ES0R/Bachelor/drone_ctrl/doc/block-control.png

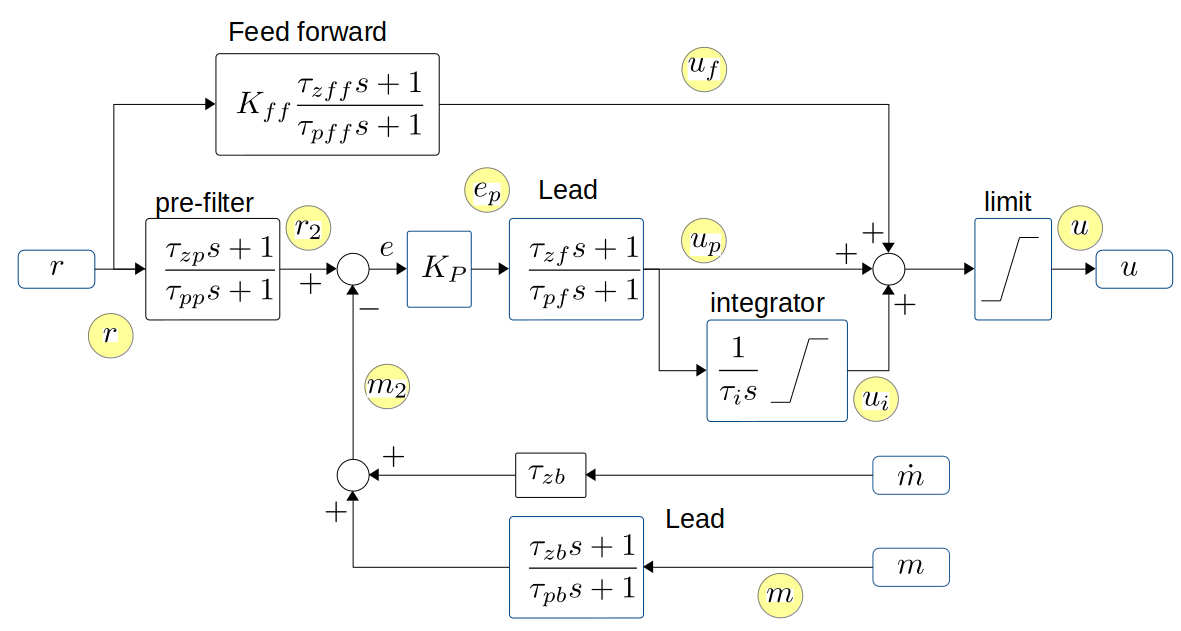
drone_ctrl/doc/block-control.png
