ES0R/Bachelor/drone_ctrl/doc/block-functions.png

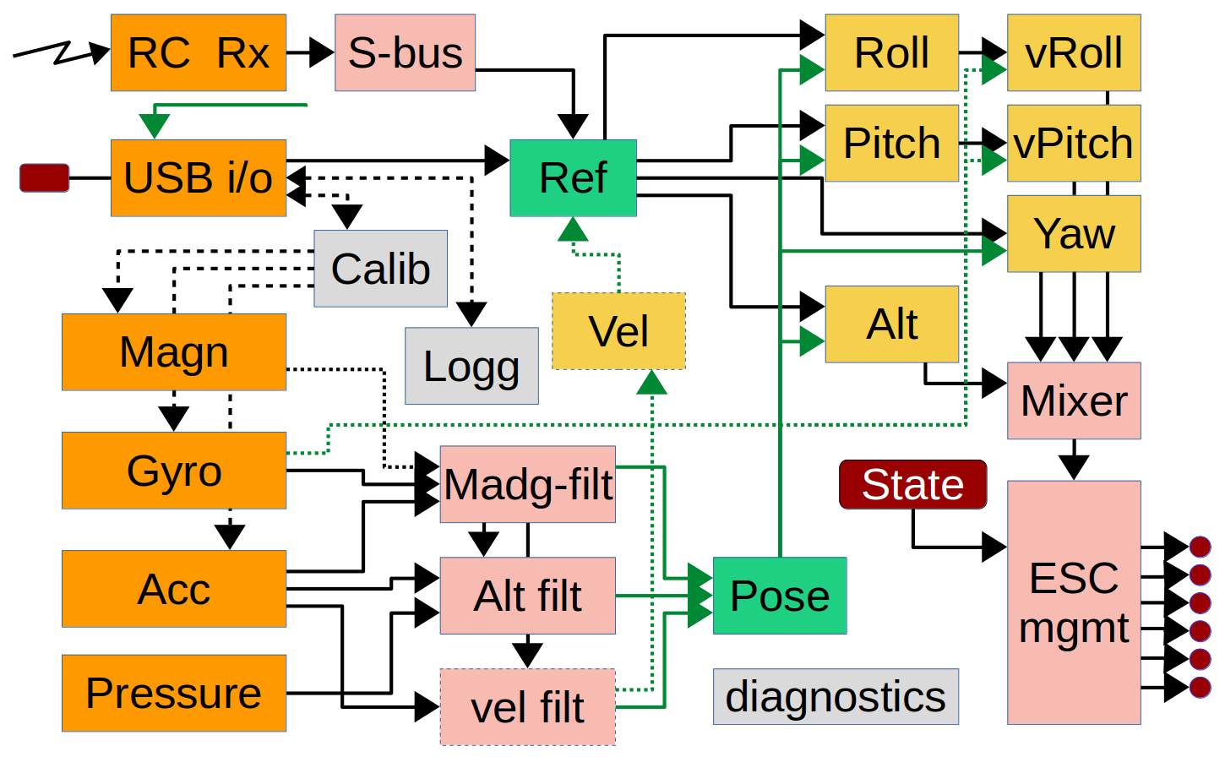
drone_ctrl/doc/block-functions.png
