ES0R/Bachelor/drone_ctrl/doc/schematic_rev1.png

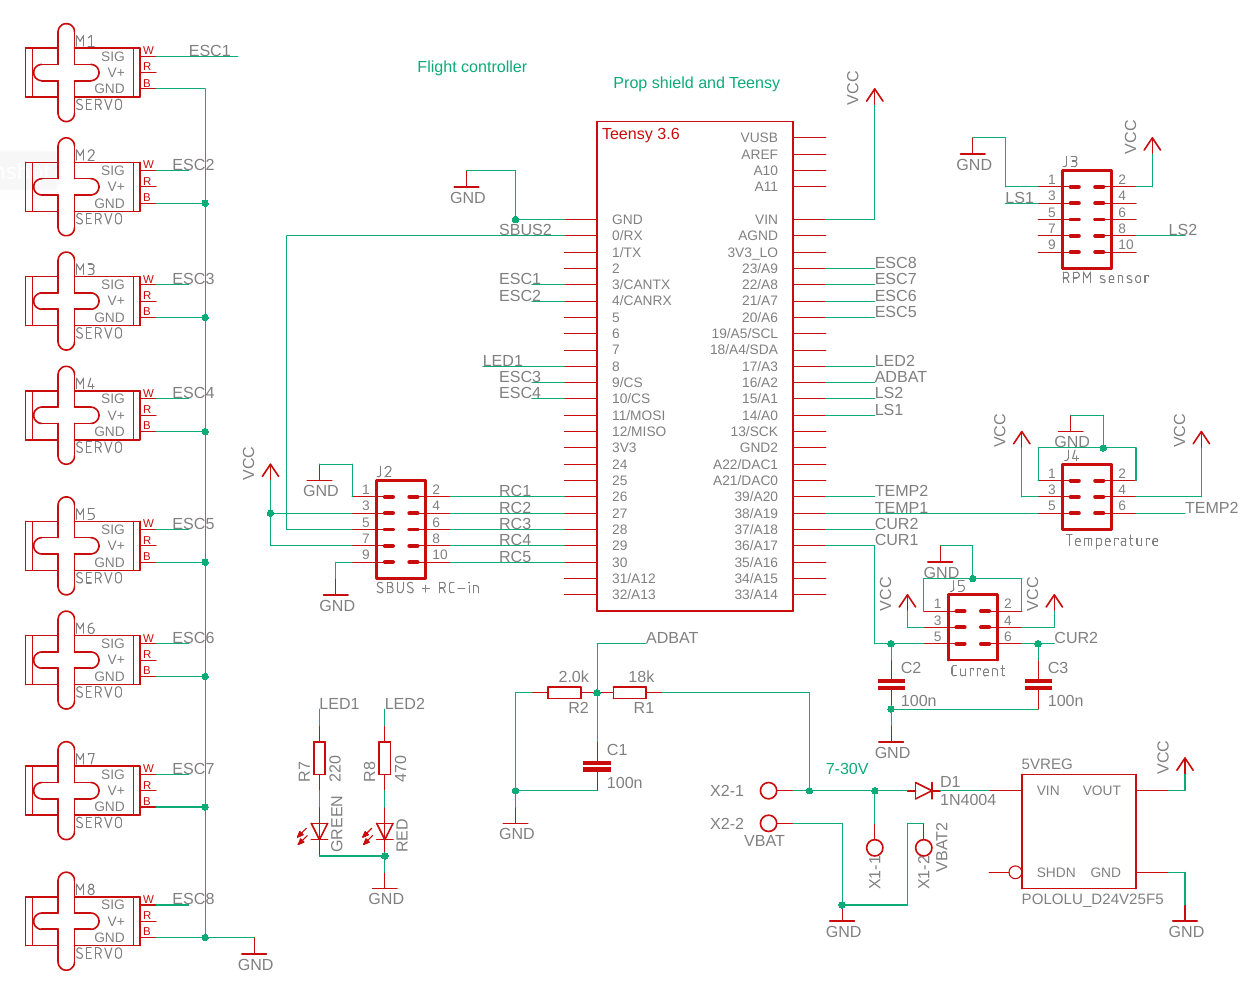
drone_ctrl/doc/schematic_rev1.png
