ES0R/Bachelor/drone_ctrl/drone_gui/log/3508-700-drag-constant.png

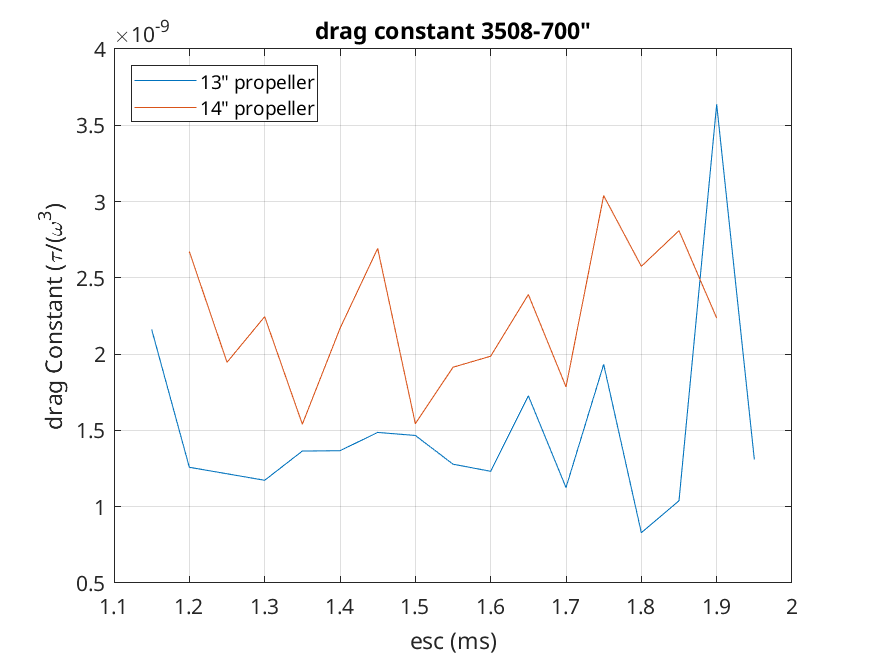
drone_ctrl/drone_gui/log/3508-700-drag-constant.png
