ES0R/Bachelor/drone_ctrl/drone_gui/log/3508-700-trust-constant.png

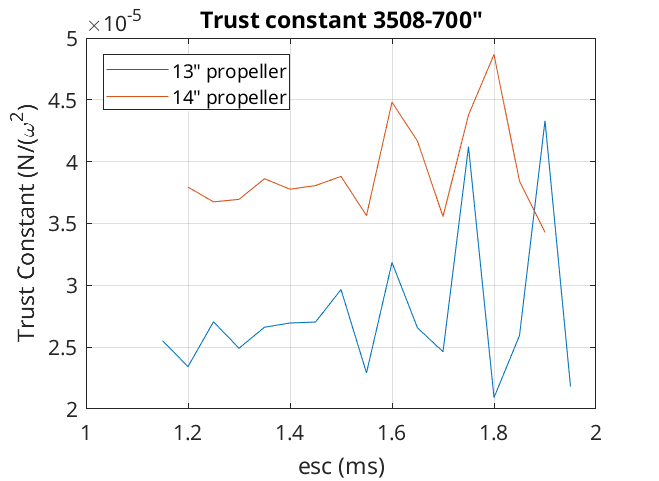
drone_ctrl/drone_gui/log/3508-700-trust-constant.png
