ES0R/Bachelor/drone_ctrl/drone_gui/log/rpm-per-power-3508-700.png

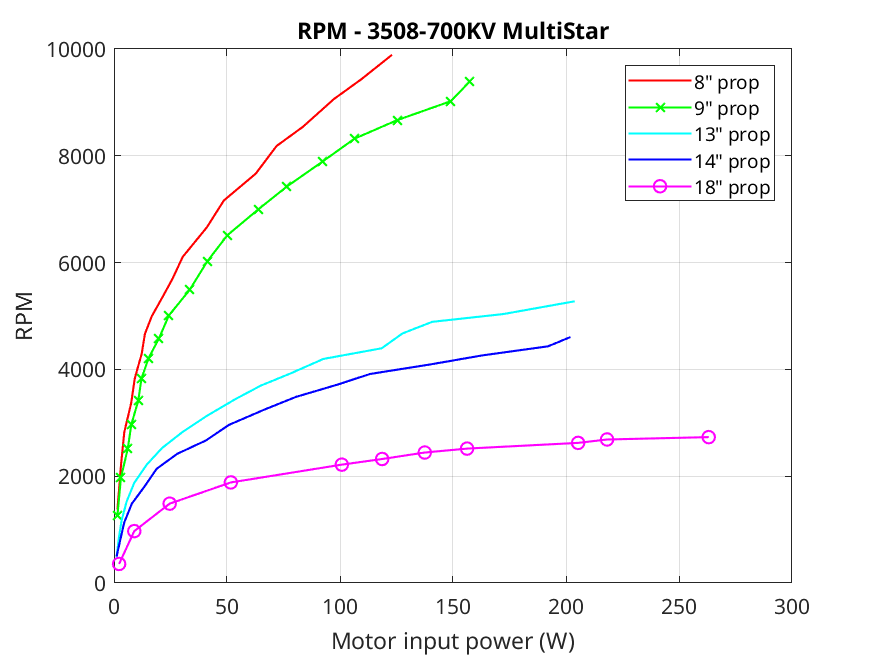
drone_ctrl/drone_gui/log/rpm-per-power-3508-700.png
