ES0R/Bachelor/drone_ctrl/drone_gui/log/transfer_gain_N-per-ms.png

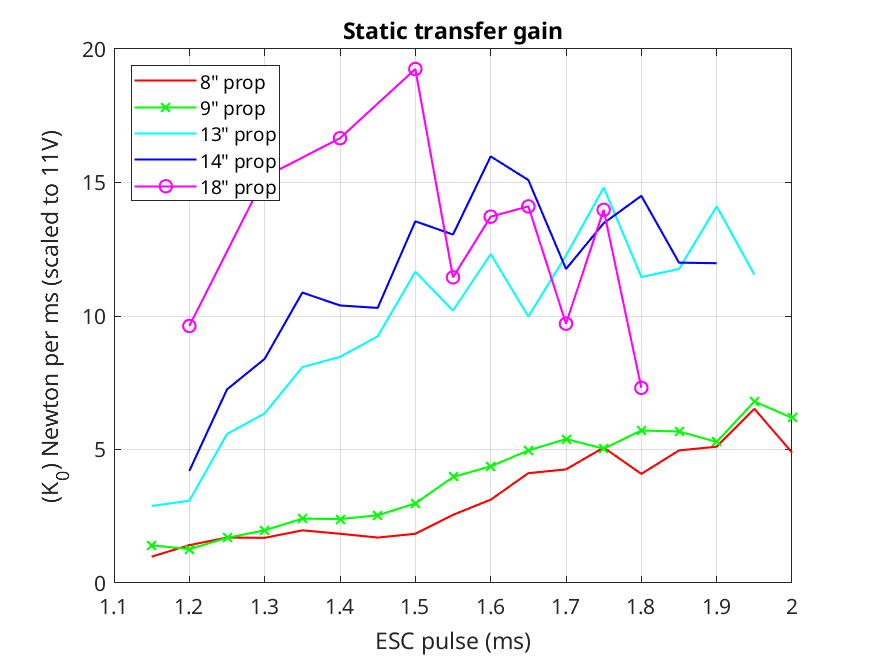
drone_ctrl/drone_gui/log/transfer_gain_N-per-ms.png
