ES0R/Bachelor/drone_ctrl/drone_gui/log/trust-3508-700_14_18x5.5.png

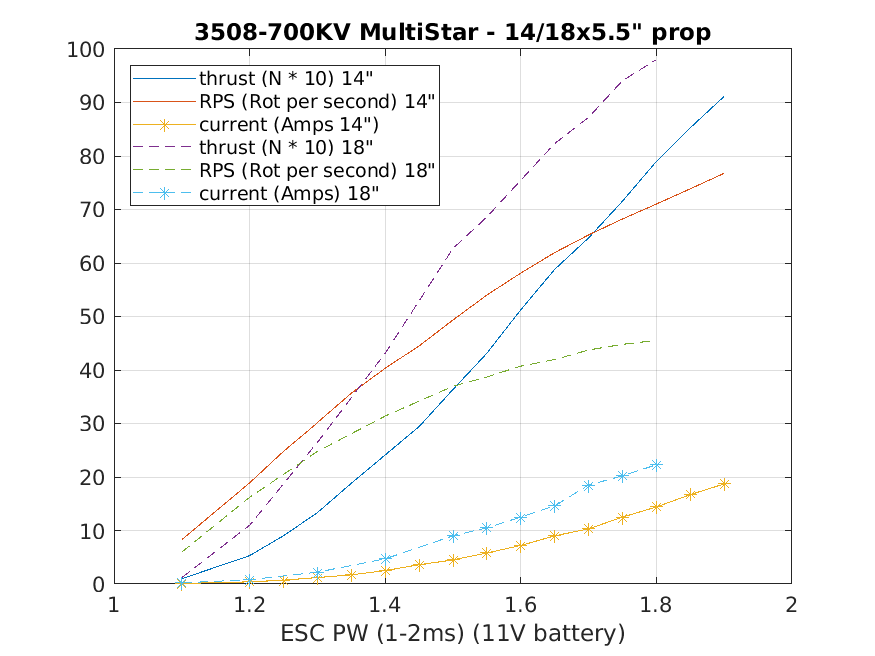
drone_ctrl/drone_gui/log/trust-3508-700_14_18x5.5.png
