ES0R/Bachelor/Drone/Matlab/battery.step

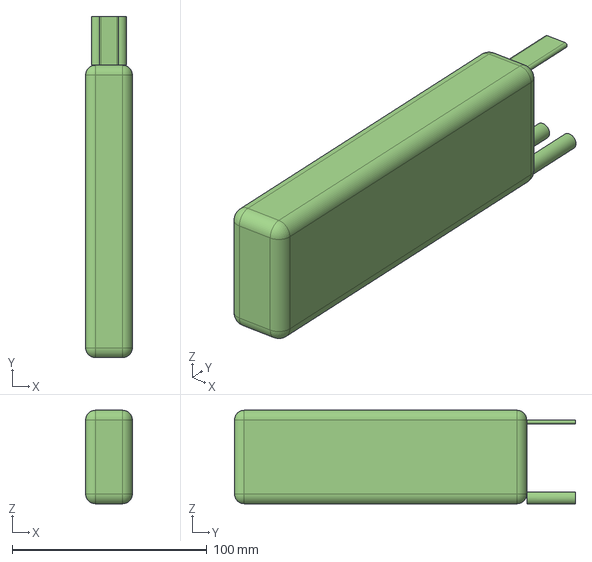
[picture p12: CAD file, 2022-02-07]
Drone/Matlab/battery.step
24.0 x 175.0 x 48.0 mm
