ES0R/Bachelor/Drone/Matlab/foot_mount.step

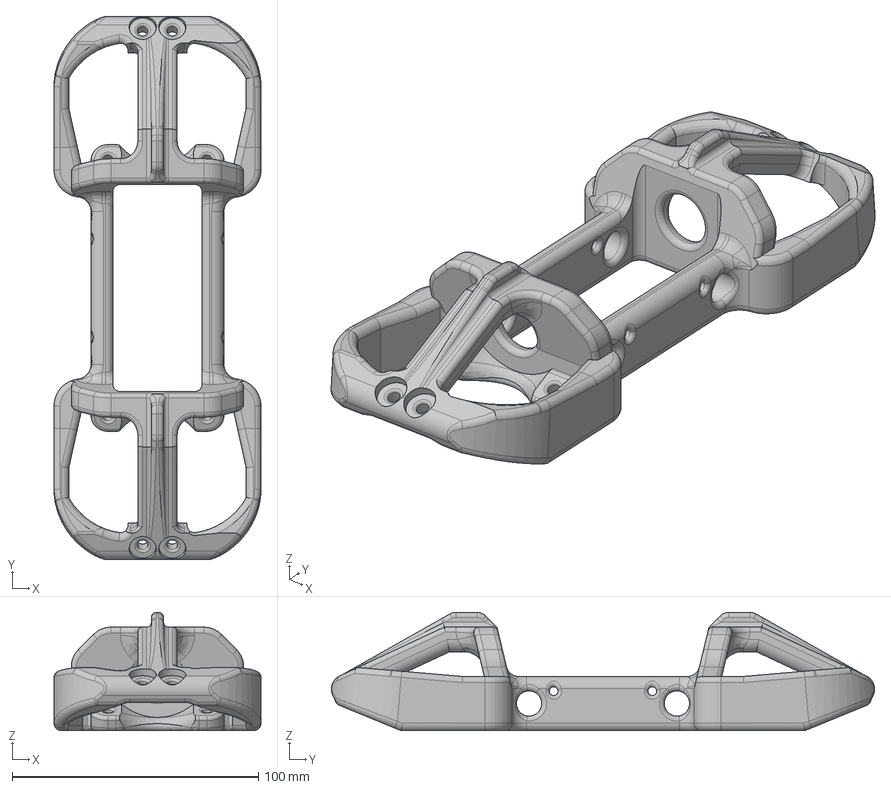
[picture p13: CAD file, 2022-02-07]
Drone/Matlab/foot_mount.step
84.0 x 220.4 x 48.0 mm
