ES0R/Bachelor/Drone/Matlab/motor-mount.step

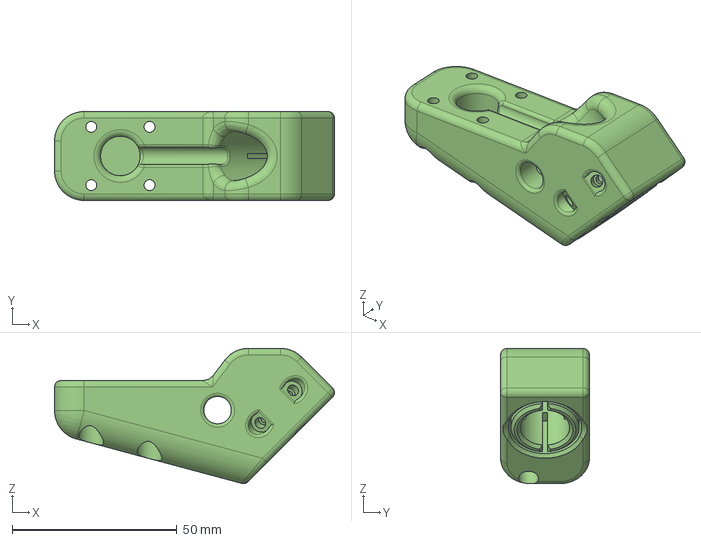
[picture p14: CAD file, 2022-02-07]
Drone/Matlab/motor-mount.step
85.0 x 27.0 x 41.0 mm
