ES0R/Bachelor/Drone/Matlab/18_inch_prop.step

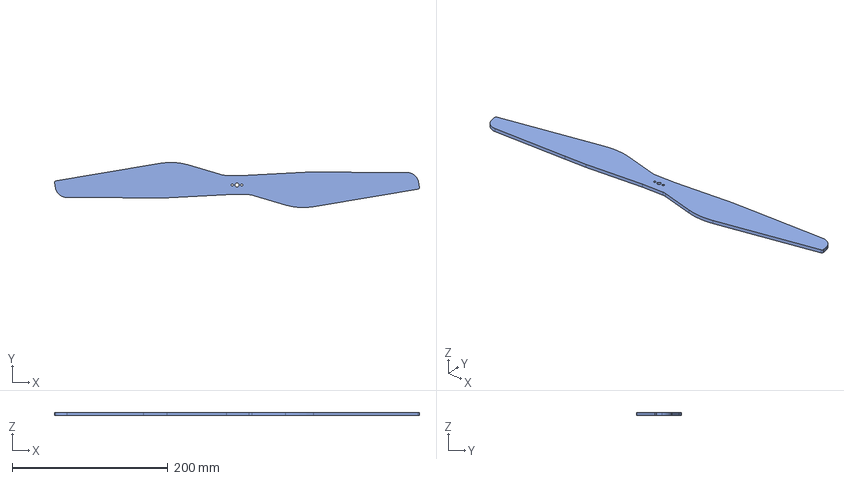
[picture p15: CAD file, 2022-02-07]
Drone/Matlab/18_inch_prop.step
469.4 x 58.0 x 4.00 mm
