ES0R/Bachelor/Drone/Matlab/leg2.step

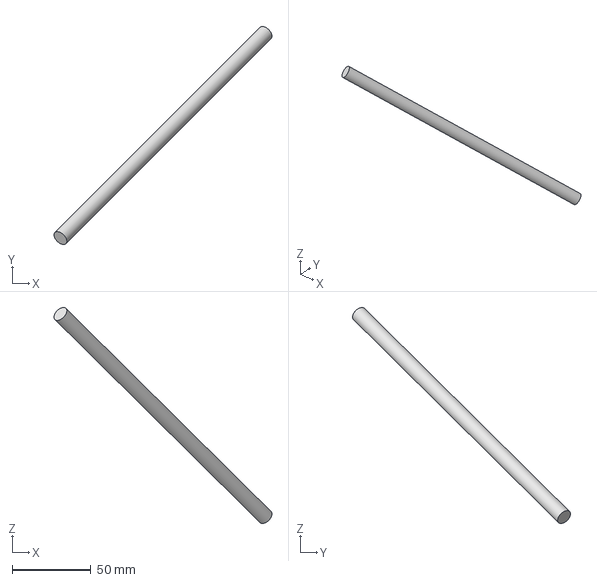
[picture p16: CAD file, 2022-02-07]
Drone/Matlab/leg2.step
138.5 x 138.5 x 137.2 mm
