ES0R/Bachelor/Drone/Matlab/Foot_ball.step

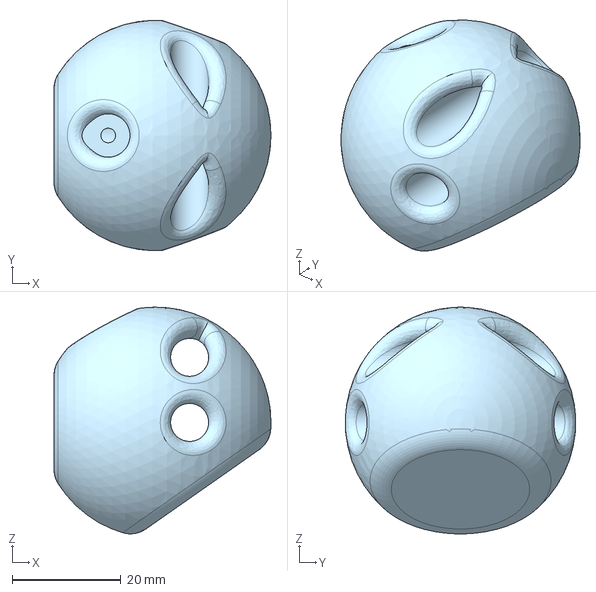
[picture p17: CAD file, 2022-02-07]
Drone/Matlab/Foot_ball.step
40.0 x 42.5 x 41.8 mm
