ES0R/Bachelor/Drone/Matlab/battery-mount_4.0.step

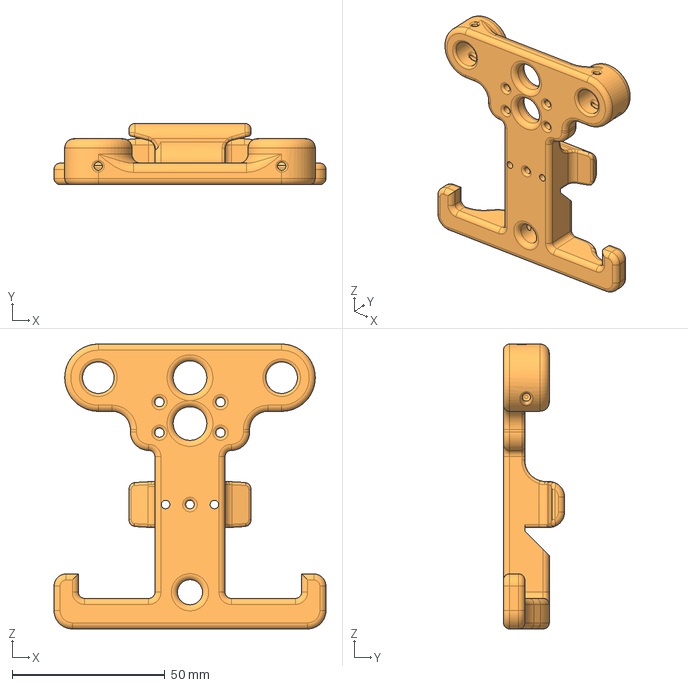
[picture p18: CAD file, 2022-02-07]
Drone/Matlab/battery-mount_4.0.step
89.0 x 20.0 x 93.2 mm
