ES0R/Bachelor/Drone/Matlab/body.step

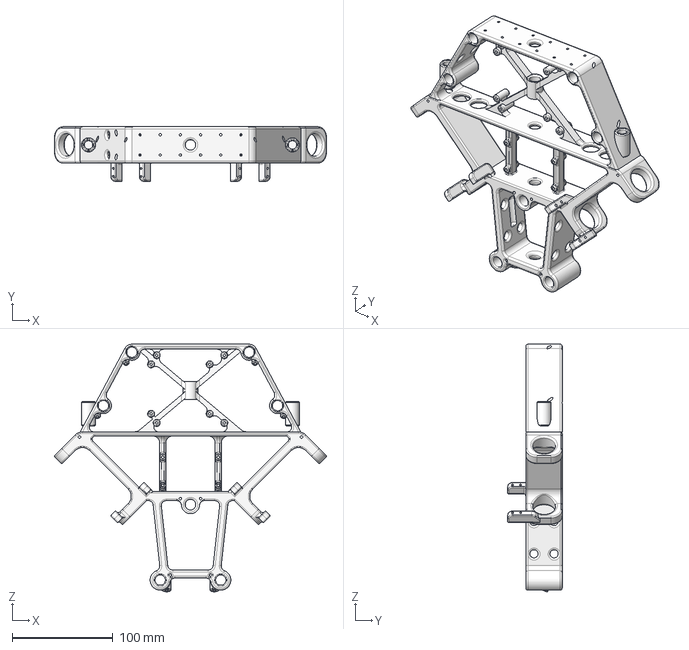
[picture p19: CAD file, 2022-02-07]
Drone/Matlab/body.step
269.5 x 54.0 x 245.4 mm
