ES0R/Bachelor/Drone/Matlab/leg-block.step

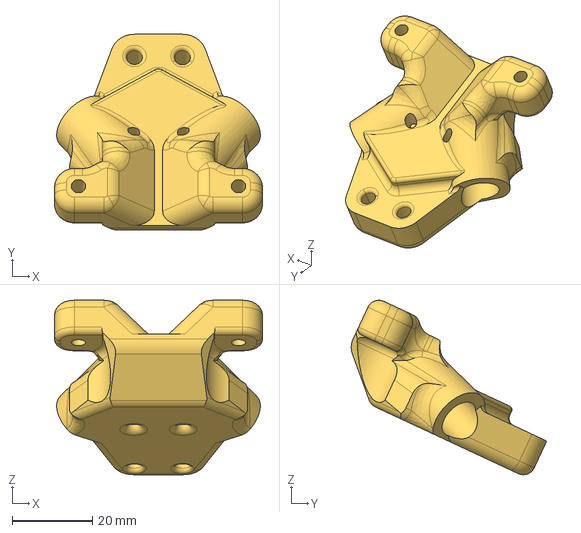
[picture p20: CAD file, 2022-02-07]
Drone/Matlab/leg-block.step
52.0 x 48.9 x 43.6 mm
