ES0R/Bachelor/drone_ctrl/drone_gui/20sYawTest9Kp.txt

% 1     Time (ms)
% 2     Arm state (init, disarmed, armed, fail)
% 3     Flight state (on ground, starting, flight, landing)
% 4     Height ref (trust ref)
% 5     Roll ref (deg)
% 6     Pitch ref (deg)
% 7     Yaw ref (deg/s)
% 8     Height value to mixer (trust ref) o/oo
% 9     Roll value to mixer o/oo
% 10    Pitch value to mixer o/oo
% 11    Yaw value to mixer o/oo
% 12    Height position (m) filtered 
% 13    Roll angle (deg)
% 14    Pitch angle (deg)
% 15    Yaw velocity (deg/s)
% 16    Height velocity (m/s)
%% 
18.44 2 0 100.00000 -0.57500 0.07500 0.15500 528.6 0.0 0.0 38.0 0.00000 -0.48015 0.85908 -4.06288 0.335 
38.41 2 0 100.00000 -0.34500 0.09000 0.46500 529.2 0.0 0.0 53.1 0.00000 -0.47085 0.93581 -5.43788 0.198 
58.42 2 0 100.00000 -0.34500 0.09000 0.00000 529.3 0.0 0.0 33.2 0.00000 -0.44765 1.07122 -3.68788 0.170 
78.44 2 0 100.00000 -0.34500 0.09000 0.00000 529.6 0.0 0.0 106.9 0.00000 -0.43171 1.02441 -11.87538 0.093 
98.25 2 0 100.00000 -0.34500 0.09000 0.00000 529.6 0.0 0.0 34.9 0.00000 -0.41148 1.27896 -3.87538 0.095 
118.43 2 0 100.00000 -0.34500 0.13500 0.00000 529.7 0.0 0.0 68.6 0.00000 -0.42207 1.39221 -7.62538 0.061 
138.40 2 0 100.00000 -0.34500 0.09000 0.00000 529.7 0.0 0.0 83.3 0.00000 -0.40525 1.41771 -9.25038 0.068 
158.42 2 0 100.00000 -0.34500 0.09000 0.00000 530.2 0.0 0.0 105.8 0.00000 -0.42379 1.62407 -11.75038 -0.054 
178.44 2 0 100.00000 -0.34500 0.09000 0.00000 530.4 0.0 0.0 -12.4 0.00000 -0.33438 1.50330 1.37462 -0.096 
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
778.40 2 0 100.00000 -0.34500 0.09000 0.00000 529.7 0.0 0.0 16.9 0.00000 -0.09906 1.50054 -1.87538 0.080 
798.44 2 0 100.00000 -0.34500 0.09000 0.00000 529.4 0.0 0.0 106.3 0.00000 -0.07761 1.44383 -11.81288 0.132 
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
