ES0R/Bachelor/drone_ctrl/doc/PCB/servo_distribute.pdf

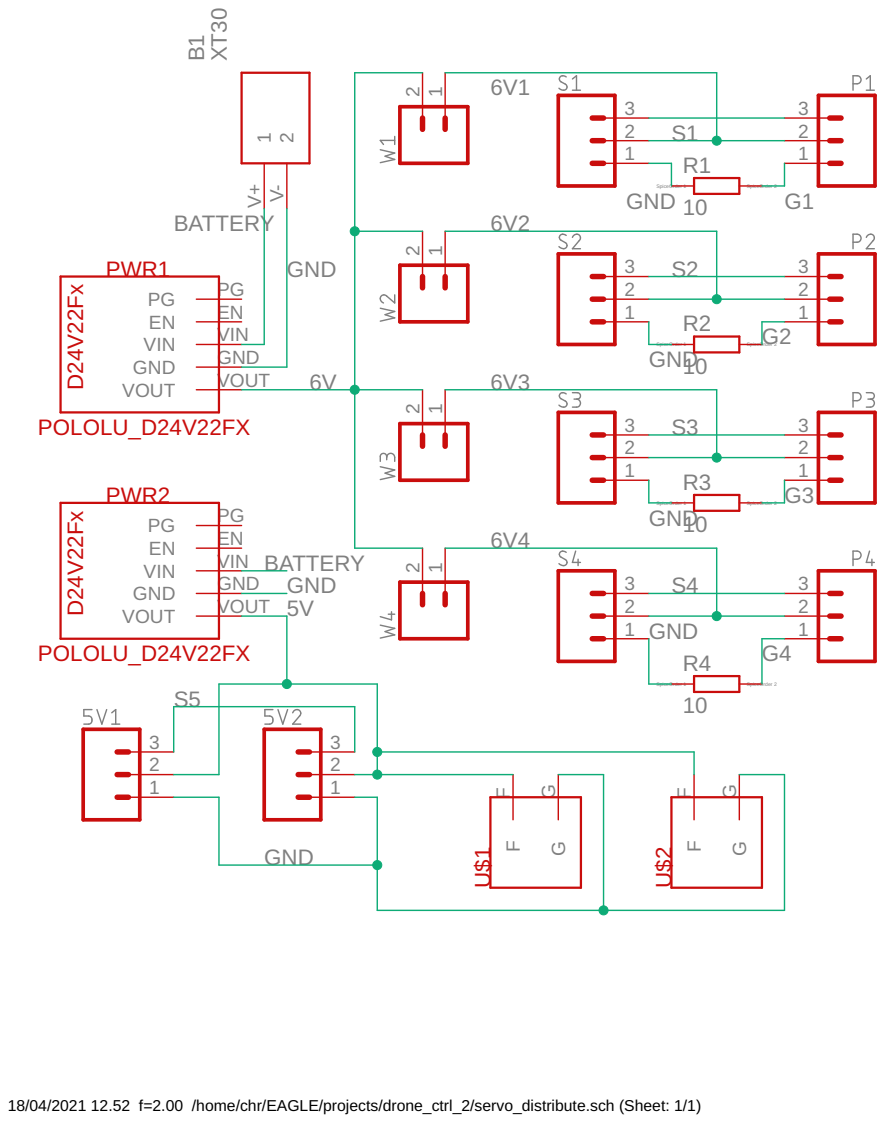
[picture p21: page 1]

18/04/2021 12.52 f=2.00 /home/chr/EAGLE/projects/drone_ctrl_2/servo_distribute.sch (Sheet: 1/1)
