ES0R/Bachelor/drone_ctrl/doc/PCB/drone_ctrl_2.pdf

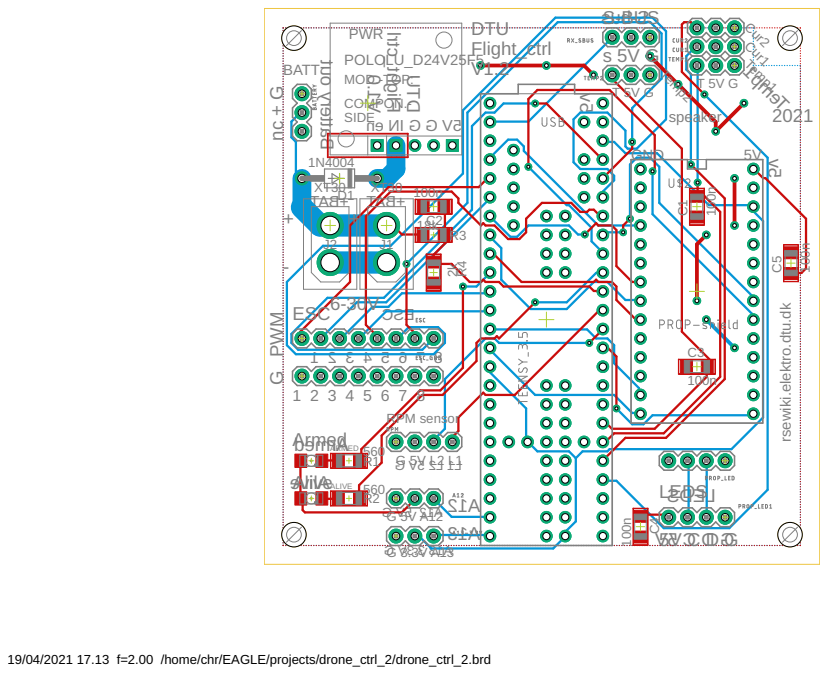
[picture p22: page 1]

19/04/2021 17.13 f=2.00 /home/chr/EAGLE/projects/drone_ctrl_2/drone_ctrl_2.brd
