ES0R/Bachelor/drone_ctrl copy/doc/PCB/power_distribute.brd

## EAGLE design drone_ctrl copy/doc/PCB/power_distribute.brd (2022-02-16, an earlier design)

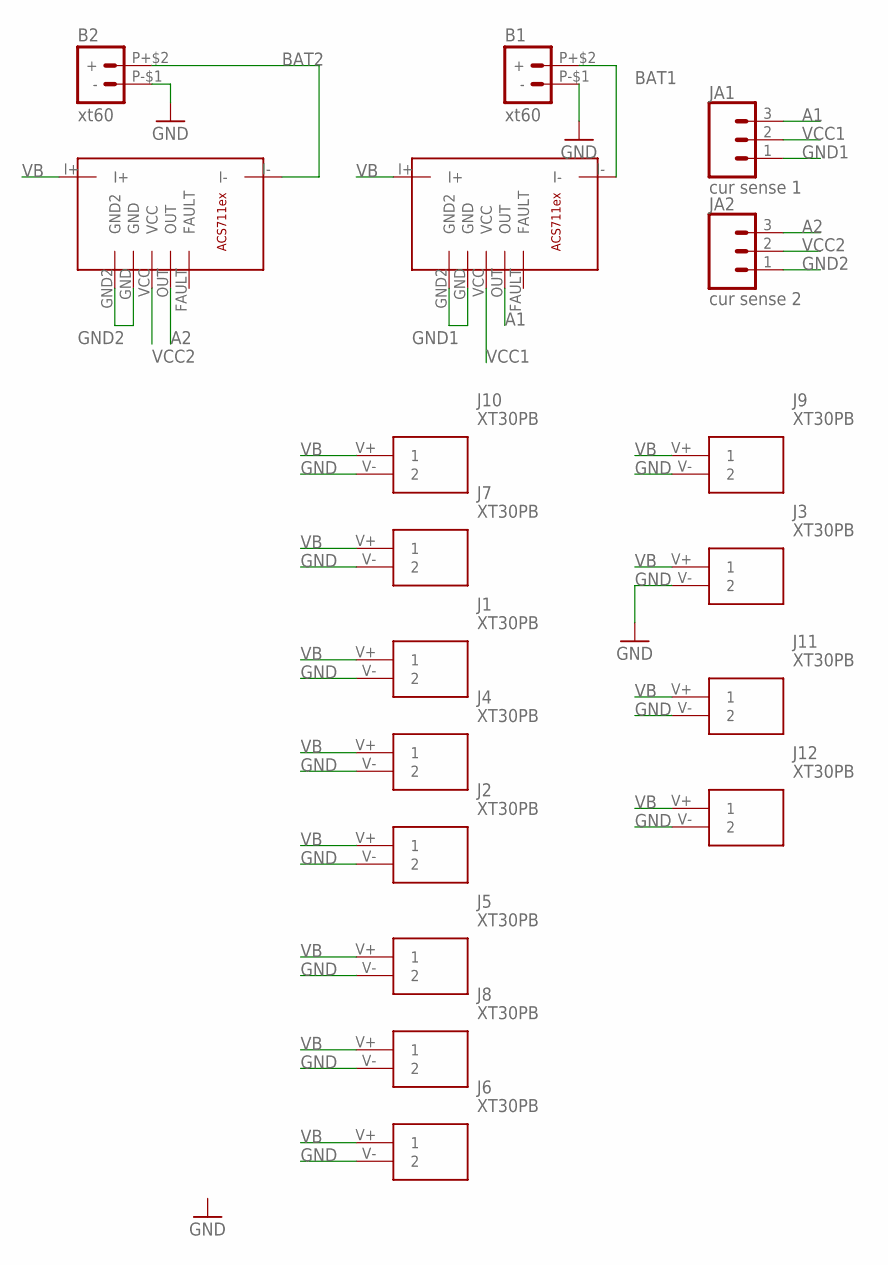
[picture p23: schematic power_distribute.sch]

Parts:
A1, A2: POLOLU_ASC711; POLOLU_ACS711
B1, B2: xt60; XT60
J1, J2, J3, J4, J5, J6, J7, J8, J9, J10, J11, J12: XT30PB
JA1: cur sense 1; 1X03
JA2: cur sense 2; 1X03

Connections:
A1: A1.OUT, JA1.3
A2: A2.OUT, JA2.3
BAT1: A1.I-, B1.P+$2 (+)
BAT2: A2.I-, B2.P+$2 (+)
GND: B1.P-$1 (-), B2.P-$1 (-), J1.V- (2), J2.V- (2), J3.V- (2), J4.V- (2), J5.V- (2), J6.V- (2), J7.V- (2), J8.V- (2), J9.V- (2), J10.V- (2), J11.V- (2), J12.V- (2)
GND1: A1.GND, A1.GND2, JA1.1
GND2: A2.GND, A2.GND2, JA2.1
VB: A1.I+, A2.I+, J1.V+ (1), J2.V+ (1), J3.V+ (1), J4.V+ (1), J5.V+ (1), J6.V+ (1), J7.V+ (1), J8.V+ (1), J9.V+ (1), J10.V+ (1), J11.V+ (1), J12.V+ (1)
VCC1: A1.VCC, JA1.2
VCC2: A2.VCC, JA2.2

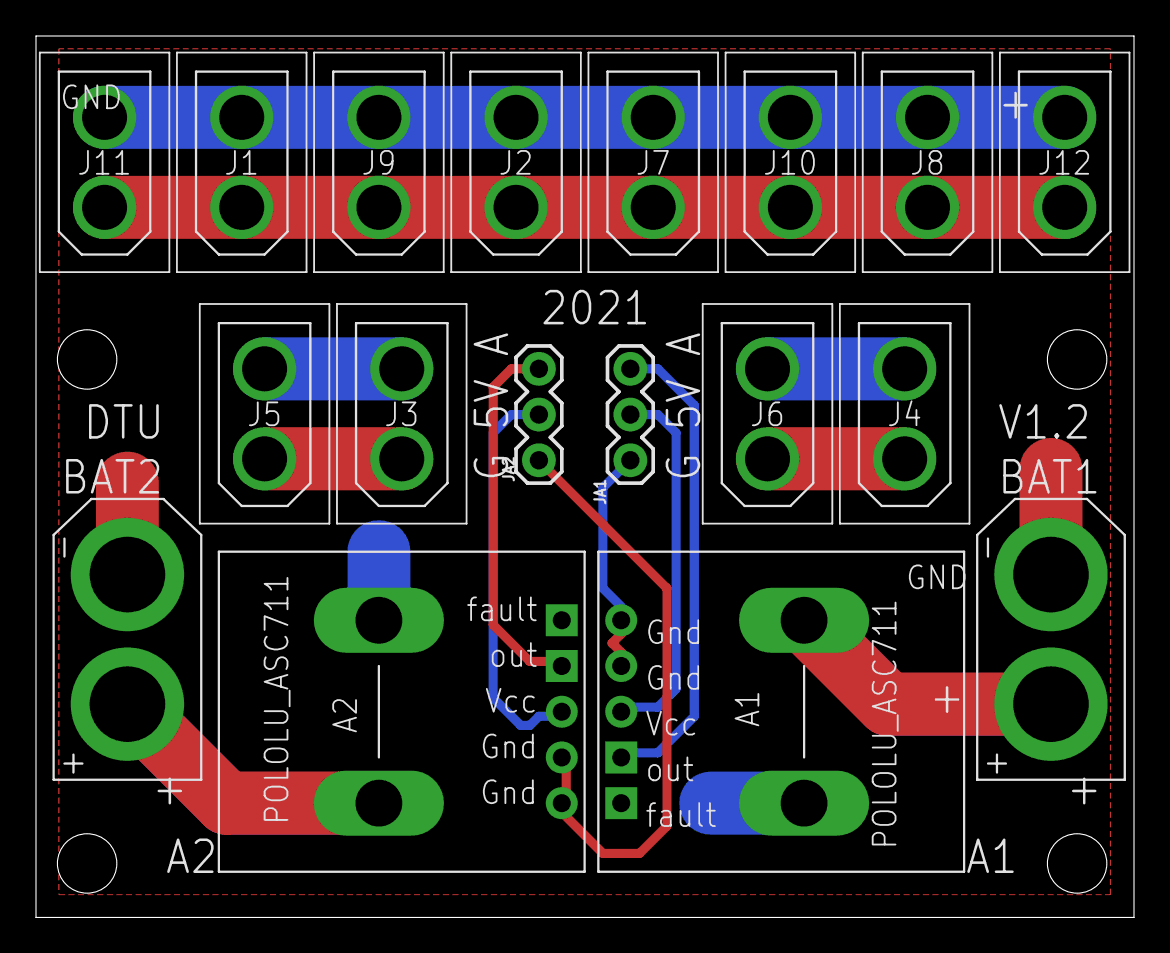
[picture p24: board power_distribute.brd from above]

Board: 2 copper layers, 61.0 x 49.0 mm, 18 parts (0 on the bottom side), 10 nets.
