ES0R/Bachelor/drone_ctrl copy/doc/PCB/servo_distribute.brd

## EAGLE design drone_ctrl copy/doc/PCB/servo_distribute.brd (2022-02-16, an earlier design)

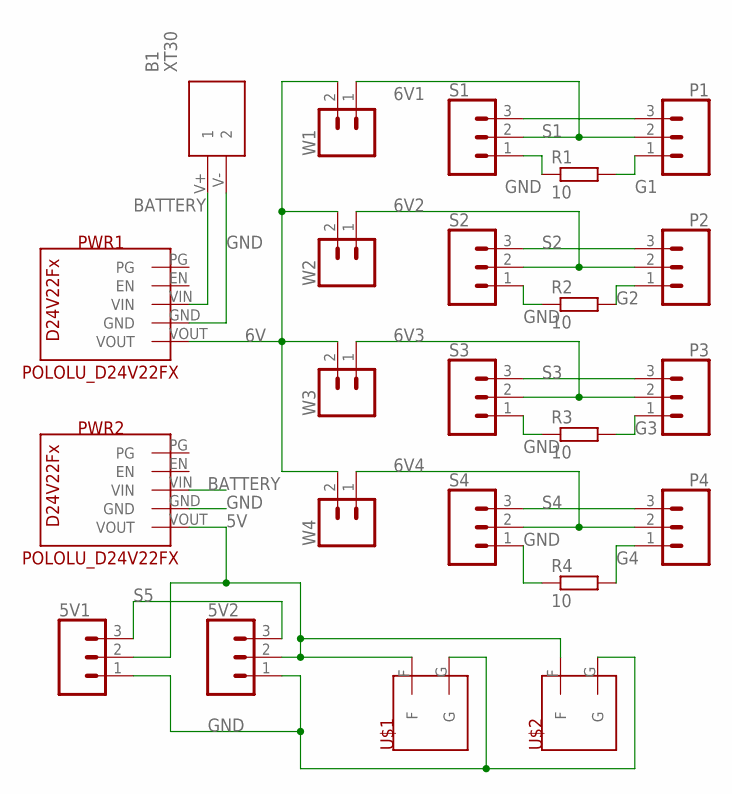
[picture p25: schematic servo_distribute.sch]

Parts:
5V1, 5V2: CONN_03; 1X03
B1: XT30; XT30PB
P1, P2, P3, P4: CONN_03; 1X03
PWR1, PWR2: POLOLU_D24V22FX; POLOLU_D24V22F6
R1, R2, R3, R4: 10; R1206
S1, S2, S3, S4: CONN_03; 1X03
U$1, U$2: TERMINAL_3.5MM
W1, W2, W3, W4: CONN_02; 1X02

Connections:
5V: 5V1.2, 5V2.2, PWR2.VOUT, U$1.F, U$2.F
6V: PWR1.VOUT, W1.2, W2.2, W3.2, W4.2
6V1: P1.2, S1.2, W1.1
6V2: P2.2, S2.2, W2.1
6V3: P3.2, S3.2, W3.1
6V4: P4.2, S4.2, W4.1
BATTERY: B1.V+ (1), PWR1.VIN, PWR2.VIN
G1: P1.1, R1.2
G2: P2.1, R2.2
G3: P3.1, R3.2
G4: P4.1, R4.2
GND: 5V1.1, 5V2.1, B1.V- (2), PWR1.GND, PWR2.GND, R1.1, R2.1, R3.1, R4.1, S1.1, S2.1, S3.1, S4.1, U$1.G, U$2.G
S1: P1.3, S1.3
S2: P2.3, S2.3
S3: P3.3, S3.3
S4: P4.3, S4.3
S5: 5V1.3, 5V2.3

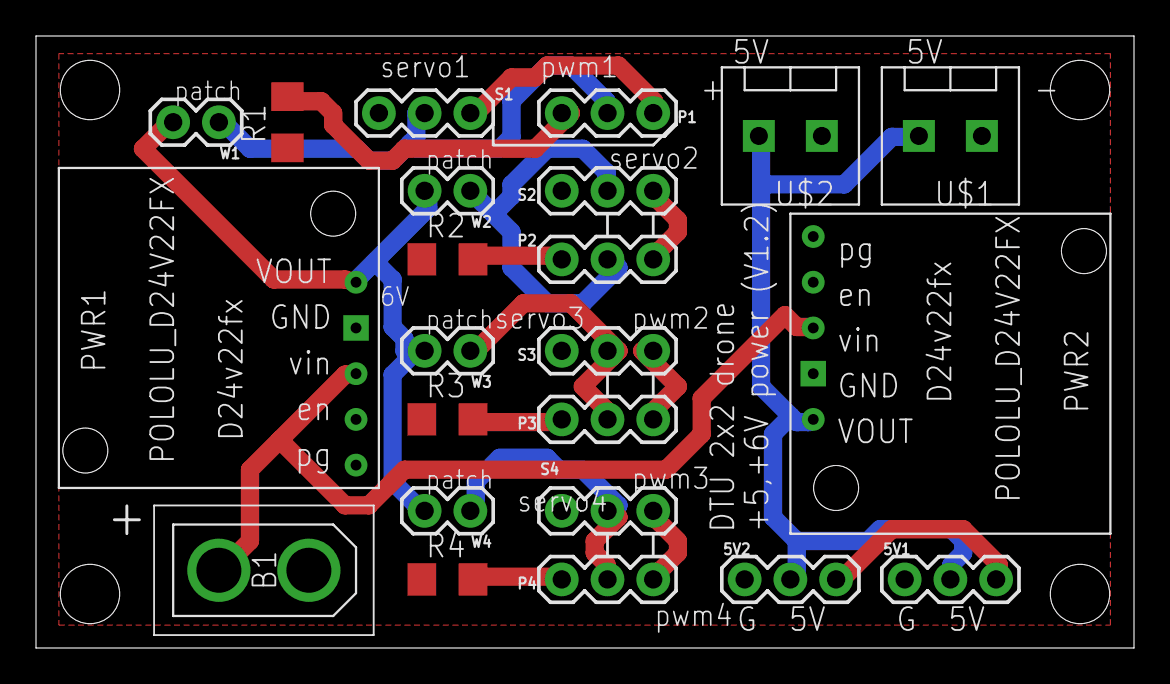
[picture p26: board servo_distribute.brd from above]

Board: 2 copper layers, 61.0 x 34.0 mm, 23 parts (0 on the bottom side), 17 nets.
