ES0R/Bachelor/drone_ctrl copy/doc/PCB/drone_ctrl_2.brd

## EAGLE design drone_ctrl copy/doc/PCB/drone_ctrl_2.brd (2022-02-16, an earlier design)

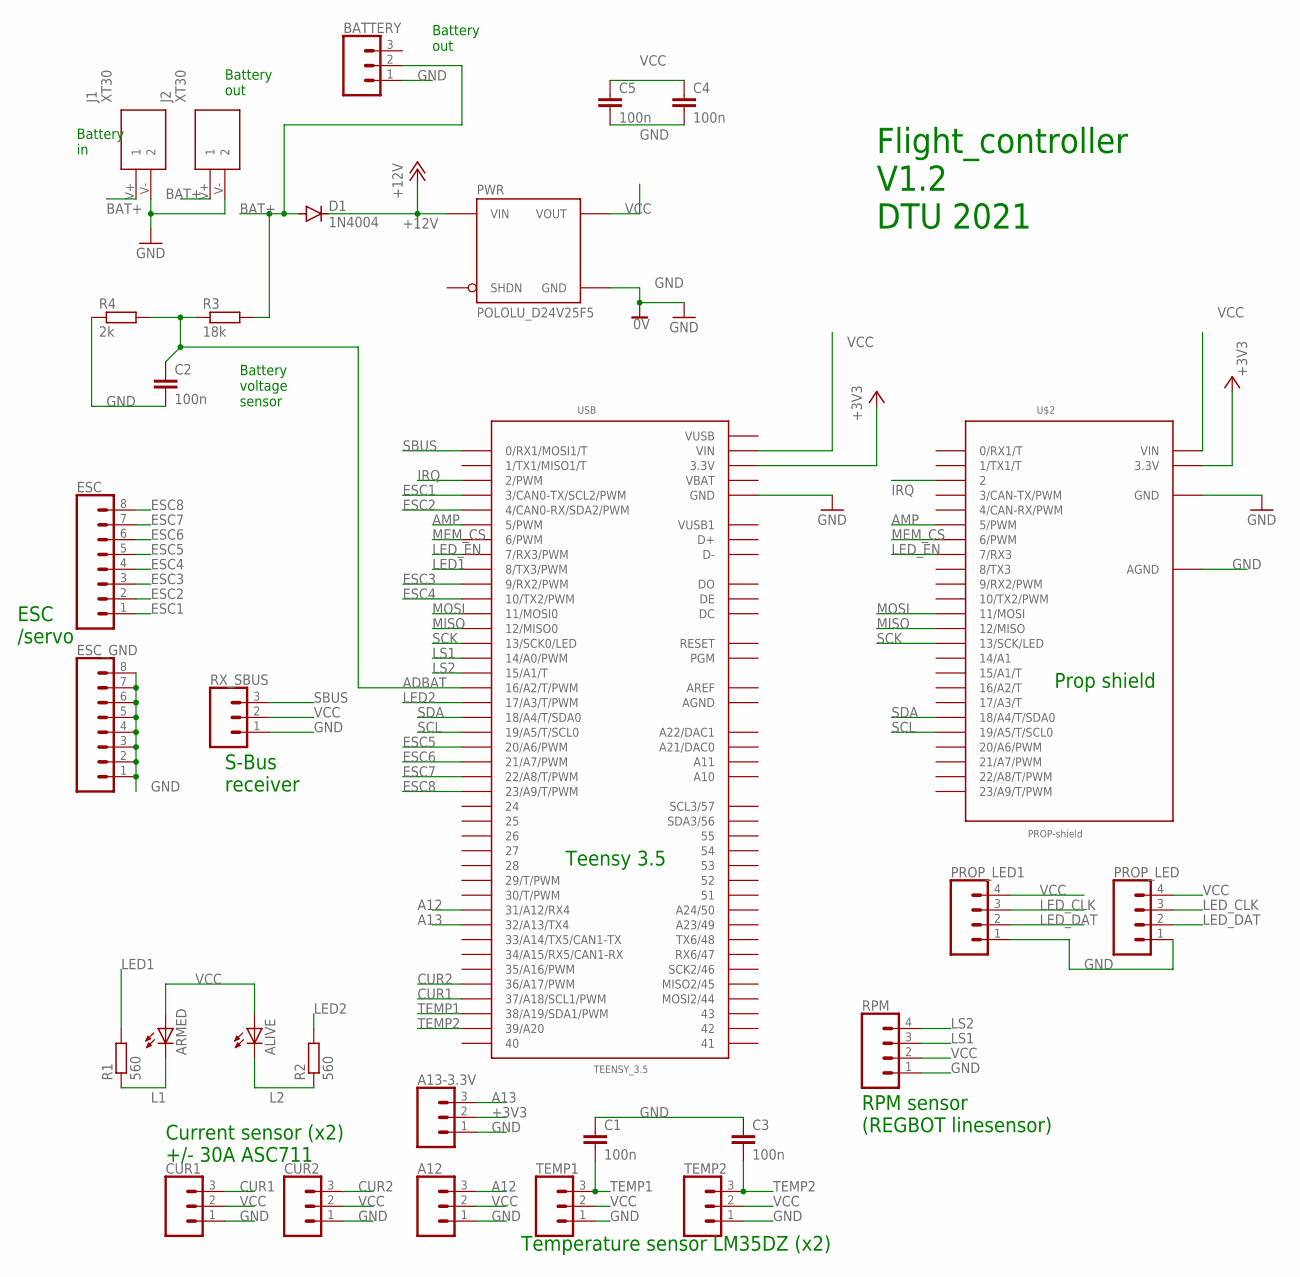
[picture p27: schematic drone_ctrl_2.sch]

Parts:
A12, A13-3.3V: CONN_03; 1X03
ALIVE: LED_E; LED_1206
ARMED: LED_E; LED_1206
BATTERY: CONN_03; 1X03
C1, C2, C3, C4, C5: 100n; C1206
CUR1, CUR2: CONN_03; 1X03
D1: 1N4004; DO41-10
ESC: CONN_08"; 1X08
ESC_GND: CONN_08"; 1X08
J1, J2: XT30; XT30PB
PROP_LED, PROP_LED1: CONN_04; 1X04
PWR: POLOLU_D24V25F5
R1, R2: 560; R1206
R3: 18k; R1206
R4: 2k; R1206
RPM: CONN_04; 1X04
RX_SBUS: CONN_03; 1X03
TEMP1, TEMP2: CONN_03; 1X03
U$2: PROP-shield; TEENSY_3.0-3.2&LC_DIL
USB: TEENSY_3.5; TEENSY_3.6_ALL_PINS&PADS

Connections:
+3V3: A13-3.3V.2, U$2.3.3V, USB.3.3V, USB.3.3V2 (3.3V), USB.3.3V3 (3.3V), USB.3.3V4 (3.3V)
+12V: D1.C, PWR.I (VIN)
A12: A12.3, USB.31/A12 (31/A12/RX4)
A13: A13-3.3V.3, USB.32/A13 (32/A13/TX4)
ADBAT: C2.1, R3.1, R4.2, USB.16/A2 (16/A2/T/PWM)
AGND: USB.AGND
AMP: U$2.5 (5/PWM), USB.5 (5/PWM)
AREF: USB.AREF
BAT+: BATTERY.2, D1.A, J1.V+ (1), J2.V+ (1), R3.2
CUR1: CUR1.3, USB.37/A18 (37/A18/SCL1/PWM)
CUR2: CUR2.3, USB.36/A17 (36/A17/PWM)
ESC1: ESC.1, USB.3 (3/CAN0-TX/SCL2/PWM)
ESC2: ESC.2, USB.4 (4/CAN0-RX/SDA2/PWM)
ESC3: ESC.3, USB.9 (9/RX2/PWM)
ESC4: ESC.4, USB.10 (10/TX2/PWM)
ESC5: ESC.5, USB.20/A6 (20/A6/PWM)
ESC6: ESC.6, USB.21/A7 (21/A7/PWM)
ESC7: ESC.7, USB.22/A8 (22/A8/T/PWM)
ESC8: ESC.8, USB.23/A9 (23/A9/T/PWM)
GND: A12.1, A13-3.3V.1, BATTERY.1, C1.1, C2.2, C3.1, C4.2, C5.2, CUR1.1, CUR2.1, ESC_GND.1, ESC_GND.2, ESC_GND.3, ESC_GND.4, ESC_GND.5, ESC_GND.6, ESC_GND.7, ESC_GND.8, J1.V- (2), J2.V- (2), PROP_LED.1, PROP_LED1.1, PWR.G (GND), PWR.G1 (GND), R4.1, RPM.1, RX_SBUS.1, TEMP1.1, TEMP2.1, U$2.AGND, U$2.GND, USB.GND, USB.GND1 (GND), USB.GND2 (GND), USB.GND3 (GND), USB.GND4 (GND), USB.GND5 (GND), USB.GND6 (GND)
IRQ: U$2.2, USB.2 (2/PWM)
L1: ARMED.C, R1.1
L2: ALIVE.C, R2.1
LED1: R1.2, USB.8 (8/TX3/PWM)
LED2: R2.2, USB.17/A3 (17/A3/T/PWM)
LED_CLK: PROP_LED.3, PROP_LED1.3
LED_DAT: PROP_LED.2, PROP_LED1.2
LED_EN: U$2.7 (7/RX3), USB.7 (7/RX3/PWM)
LS1: RPM.3, USB.14/A0 (14/A0/PWM)
LS2: RPM.4, USB.15/A1 (15/A1/T)
MEM_CS: U$2.6 (6/PWM), USB.6 (6/PWM)
MISO: U$2.12 (12/MISO), USB.12 (12/MISO0)
MOSI: U$2.11 (11/MOSI), USB.11 (11/MOSI0)
SBUS: RX_SBUS.3, USB.0 (0/RX1/MOSI1/T)
SCK: U$2.13 (13/SCK/LED), USB.13 (13/SCK0/LED)
SCL: U$2.19/A5 (19/A5/T/SCL0), USB.19/A5 (19/A5/T/SCL0)
SDA: U$2.18/A4 (18/A4/T/SDA0), USB.18/A4 (18/A4/T/SDA0)
TEMP1: C1.2, TEMP1.3, USB.38/A19 (38/A19/SDA1/PWM)
TEMP2: C3.2, TEMP2.3, USB.39/A20
VBAT: USB.VBAT
VCC: A12.2, ALIVE.A, ARMED.A, C4.1, C5.1, CUR1.2, CUR2.2, PROP_LED.4, PROP_LED1.4, PWR.O (VOUT), RPM.2, RX_SBUS.2, TEMP1.2, TEMP2.2, U$2.VIN, USB.VIN
VUSB: USB.VUSB
VUSB1: USB.VUSB1

Notes on the sheet:
Flight_controller V1.2 DTU 2021
RPM sensor (REGBOT linesensor)
Current sensor (x2) +/- 30A ASC711
Temperature sensor LM35DZ (x2)
ESC /servo
S-Bus receiver
Battery voltage sensor
Prop shield
Teensy 3.5
Battery in
Battery out

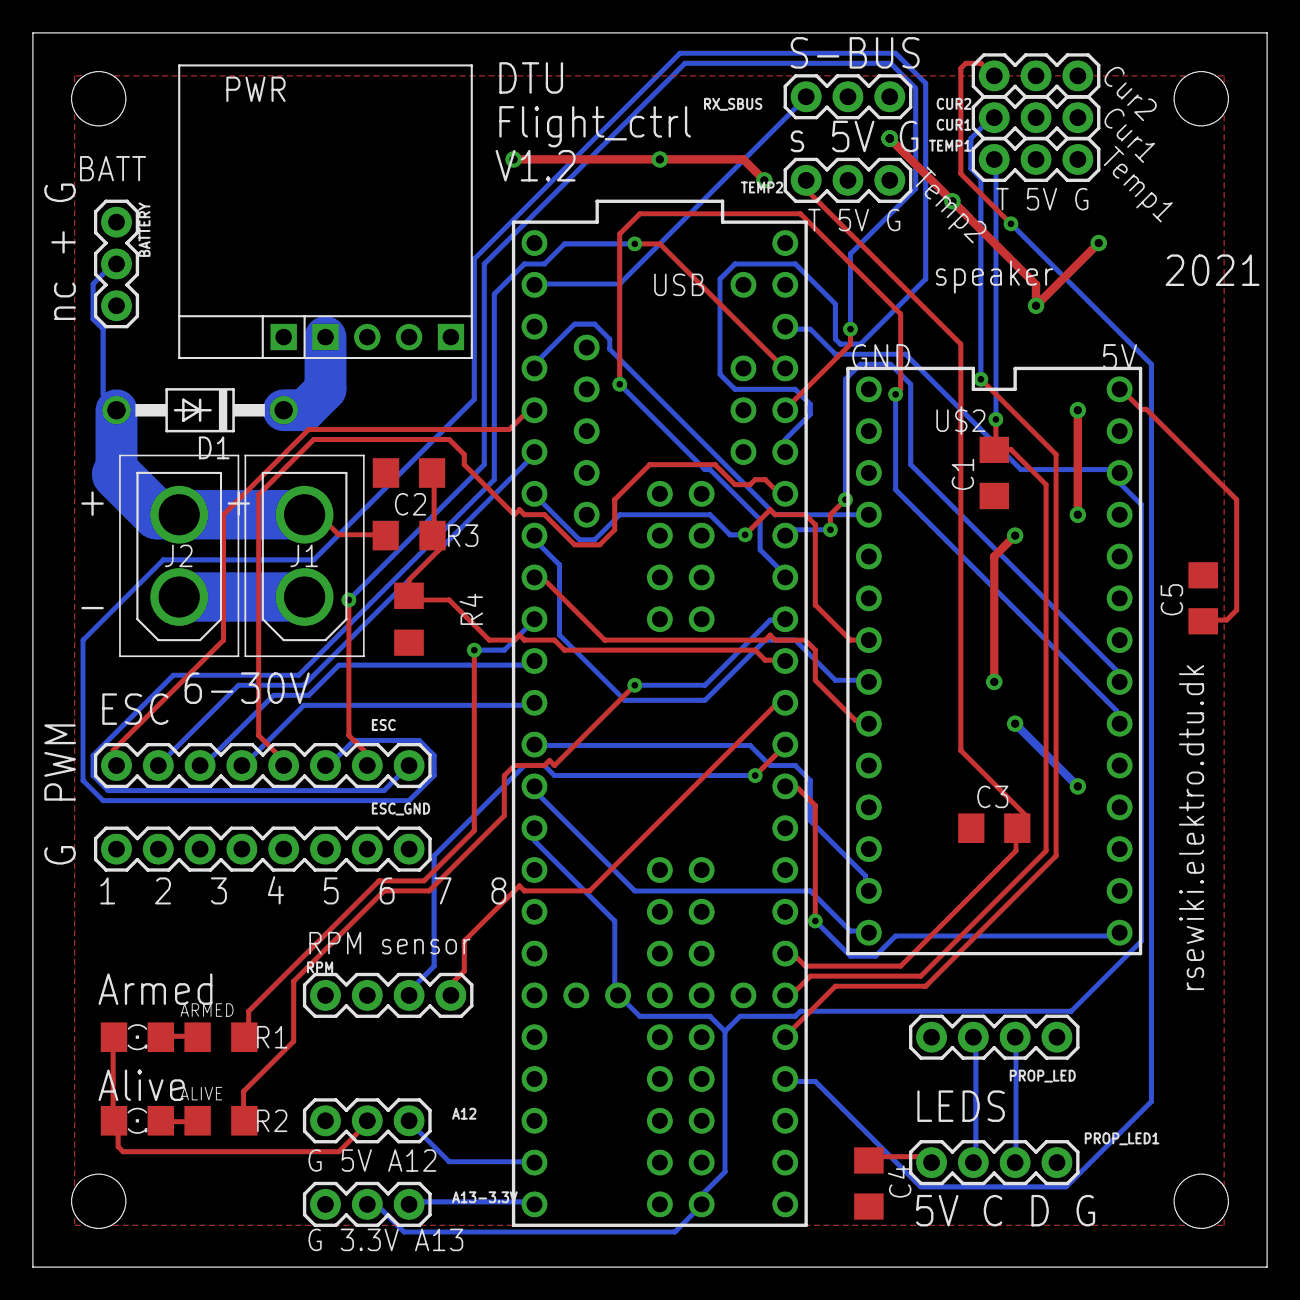
[picture p28: board drone_ctrl_2.brd from above]

Board: 2 copper layers, 75.0 x 75.0 mm, 30 parts (0 on the bottom side), 38 nets.
