ES0R/Bachelor/(commit log)

2022-02-07 Adding simulation bachelor project
    [18_inch_prop.step, Foot_ball.step, battery-mount_4.0.step, battery.step, body.step, foot_mount.step, leg-block.step, leg2.step]
2022-02-16 Added drone control files
    [18_inch_prop.step, Foot_ball.step, battery-mount_4.0.step, battery.step, body.step, drone_ctrl_2.brd, drone_ctrl_2.sch, foot_mount.step]
