ES0R/Bachelor/(notices)

Notices in the files:
drone_ctrl/drone_ctrl/src/sensor.cpp:
the Free Software Foundation, either version 3 of the License, or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
parts and their libraries:
SparkFun-Connectors: Licensing: Creative Commons ShareAlike 4.0 International - https://creativecommons.org/licenses/by-sa/4.0
